josto-me/electric_race_kart/hardware/pdf/io-board-schematic.pdf

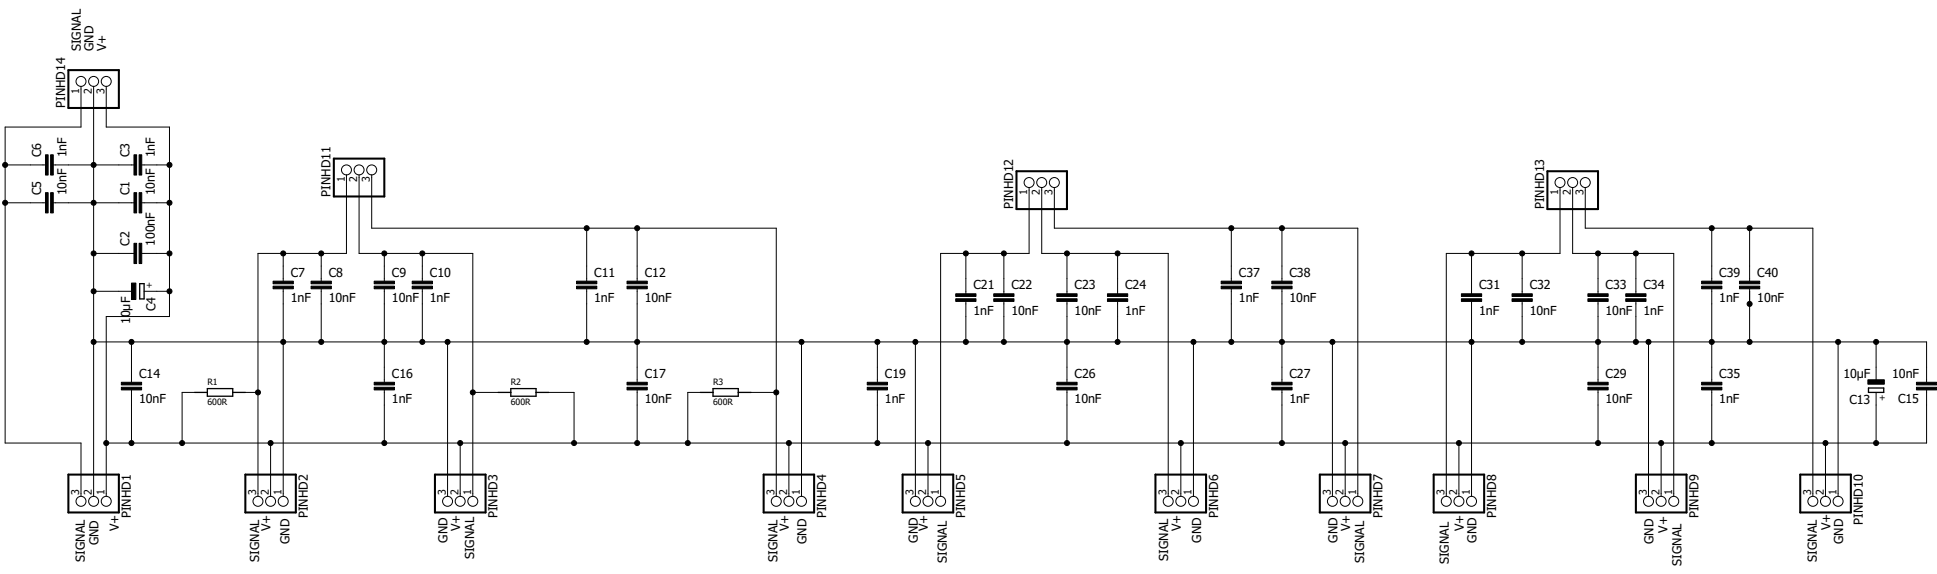
[picture p1: page 1]

10nF 100nF 1nF 10µF 10nF 1nF 1nF 10nF 10nF 1nF 1nF 10nF 10nF 1nF 10nF 1nF 1nF 10nF 10nF 1nF 10nF 1nF 10nF 1nF 10nF 10nF 1nF 1nF 1nF 10nF 1nF 10nF 10µF 10nF 600R 600R 600R PINHD1 321 PINHD2 321 PINHD3 321 PINHD4 321 PINHD5 321 PINHD6 321 PINHD7 321 PINHD8 321 PINHD9 321 PINHD10 321 PINHD11 123 PINHD12 123 PINHD13 123 PINHD14 123 C1 C2 C3 C4 C5 C6 C7 C8 C9 C10 C11 C12 C14 C16 C17 C19 C21 C22 C23 C24 C26 C27 C29 C31 C32 C33 C34 C35 C37 C38 C39 C40 C13 C15 R1 R2 R3 + + GND V+SIGNAL V+V+V+V+V+V+V+V+V+V+ GND GND GND GND GND GND GND GND GND GND SIGNAL SIGNAL SIGNAL SIGNAL SIGNAL SIGNAL SIGNAL SIGNAL SIGNAL SIGNAL
