josto-me/electric_race_kart/hardware/pdf/io-board-layout.pdf

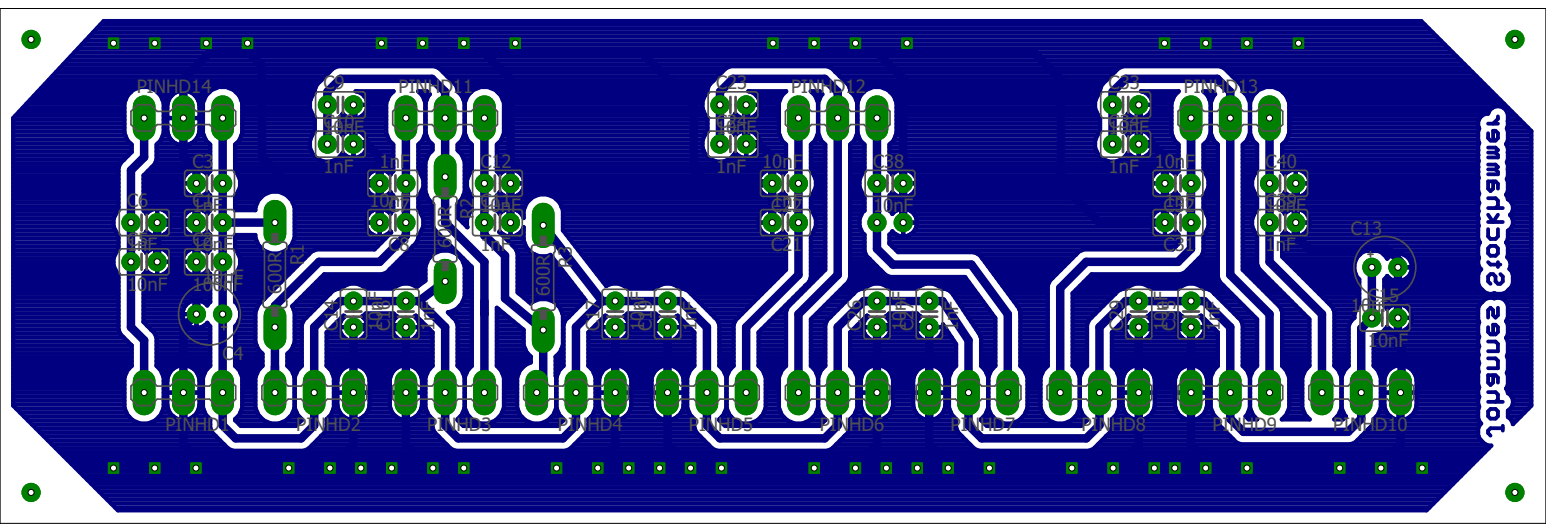
[picture p2: page 1]
