josto-me/electric_race_kart/hardware/pdf/motor-controller-interface-layout.pdf

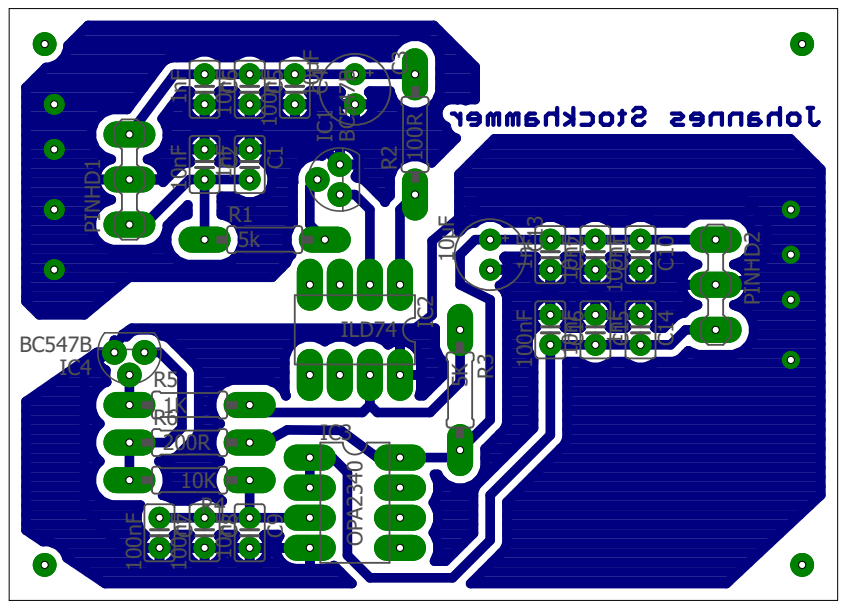
[picture p3: page 1]
