josto-me/electric_race_kart/hardware/pdf/motor-controller-interface-schematic.pdf

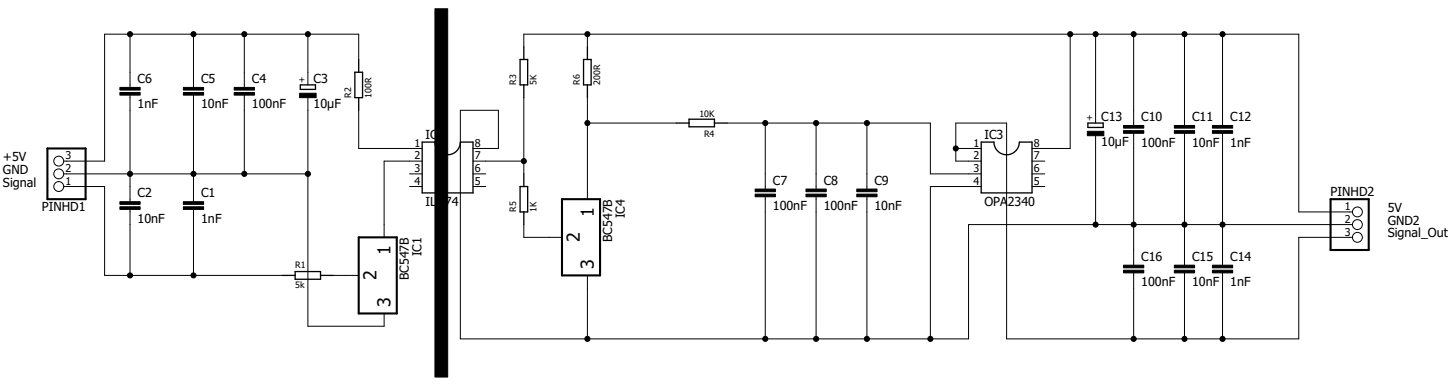
[picture p4: page 1]
