josto-me/electric_race_kart/hardware/pdf/power-supply-layout.pdf

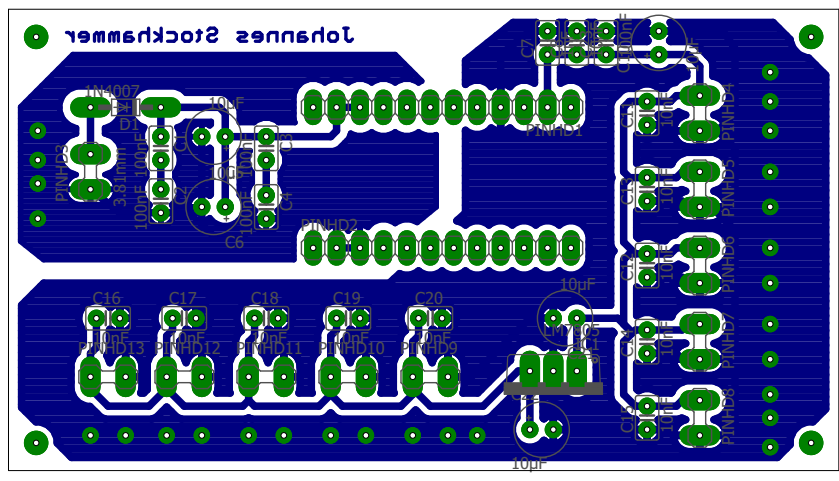
[picture p5: page 1]
