josto-me/electric_race_kart/hardware/pdf/power-supply-schematic.pdf

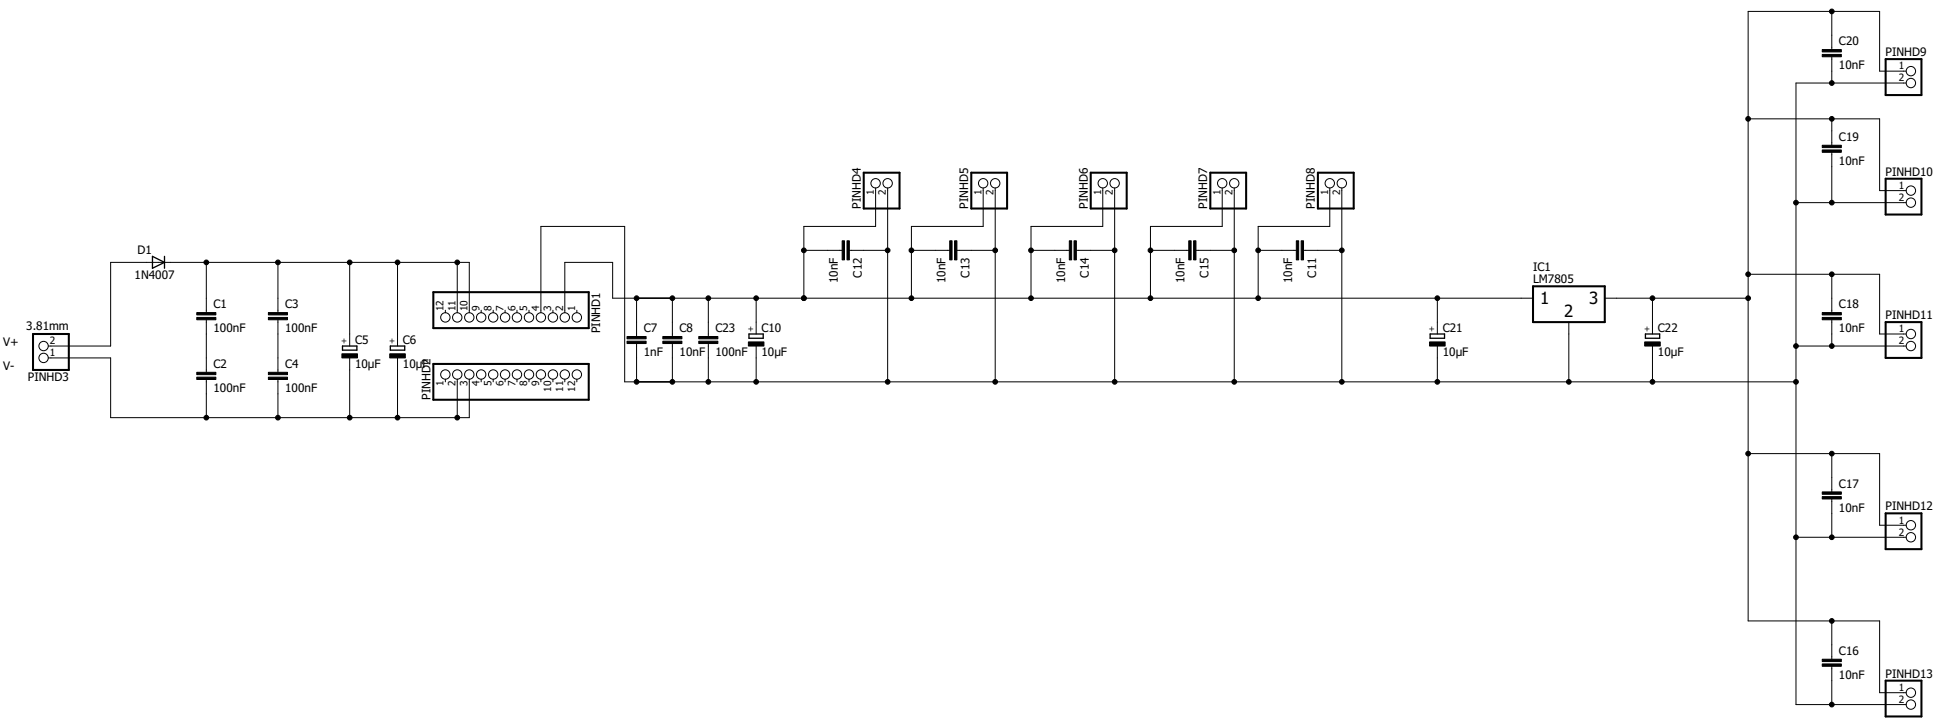
[picture p6: page 1]
