josto-me/electric_race_kart/firmware/E_Kart/Slip_Detect.h

// SPDX-FileCopyrightText: Johannes Stockhammer
// SPDX-License-Identifier: Apache-2.0
/*
 * Slip_Detect.h
 *
 *  Author: Johannes Stockhammer
 */


#ifndef SLIP_DETECT_H_
#define SLIP_DETECT_H_

#include "Kart.h"
bool Slip_Detect(uint32_t period_front, uint32_t period_rear);

#endif /* SLIP_DETECT_H_ */
