josto-me/electric_race_kart/firmware/E_Kart/Speed_Calc.h

// SPDX-FileCopyrightText: Johannes Stockhammer
// SPDX-License-Identifier: Apache-2.0
/*
 * Speed_Calc.h
 *
 *  Author: Johannes Stockhammer
 */


#ifndef SPEED_CALC_H_
#define SPEED_CALC_H_

#include "Kart.h"
uint16_t Speed_Calc(uint32_t period_front);

#endif /* SPEED_CALC_H_ */
