josto-me/electric_race_kart/firmware/E_Kart/Throttle_Read.h

// SPDX-FileCopyrightText: Johannes Stockhammer
// SPDX-License-Identifier: Apache-2.0
/*
 * Throttle_Read.h
 *
 *  Author: Johannes Stockhammer
 */


#ifndef THROTTLE_READ_H_
#define THROTTLE_READ_H_

#include "Kart.h"
uint16_t Throttle_Read(int32_t adc);

#endif /* THROTTLE_READ_H_ */
