josto-me/electric_race_kart/(commit log)

2026-09-27 Initial public release
    [battery-calculation.xlsx, charging-curve.xlsx, motor-calculation.xlsx]
2026-09-27 Schematics and layouts exported again (PDF), version 1.0.1
