josto-me/electric_race_kart/(notices)

Notices in the files:
README.md:
Docs: CC BY 4.0
